Azzziel/Lulus-Online/README.md

# Lulus-Online

is a repository for me and Ivan's final project.
For any of you who stalk around and find your way here, just close, you won't find anything useful :)
