Azzziel/Lulus-Online/Site Hardware/_Asset/Note/Battery Life Calculation.xlsx

Sensor Life Calculation
Expectancy : |  | 1067.408923 |  | Days
Parameter
Timetable |  |  | Current Consumption
1 Day | 24 | hour | Battery Size | 10800 | mAh
Data Sending (20 car) | 100 | times | Arduino Pro Mini |  | mA
Sensor Read (Interval) | 3 | seconds | Sleep | 0.004
Work | 0.2 |  | Work | 3.58
Sleep | 2.8 |  | QMC58831
Park Re-check (Delay) | 5 |  | Idle | 0.002
Work | 0.2 |  | Work | 0.1
Sleep | 4.8 |  | HC12
Data Sending (Duration) | 7 |  | Sleep | 0.022
Sending | 2 |  | Work | 16
Acknowledge | 5 |  | Indicator Resistor (4v on 680k) | 0.005
Standby Time | 0 | hour
Activities
Sensor Read |  |  | Data Sending
Time Calculation |  |  | Time Calculation
1 hour / interval |  |  | 24 hour / count
n : | 1200 |  | n : | 4.1667
t [work]: | 0.0667 |  | t [HC_send]: | 0.0023
t [sleep]: | 0.9333 |  | t [HC_ack]: | 0.0058
 |  |  | t [Re-check_work]: | 0.0002
 |  |  | t [Re-check_sleep]: | 0.0056
Capacity Usage |  |  | Capacity Usage
mAh = I x t | [current, time] |  | mAh = I x t | [current, time]
Work | 0.2471333333 | mAh | HC Send | 0.04534 | mAh
Sleep | 0.0308 |  | HC Acknowledge | 0.11335
Total [1 hour] | 0.2779333333 | mAh | Sensor Work | 0.00086
 |  |  | Sensor Sleep | 0.00018
 |  |  | Total [1 hour] | 0.15973 | mAh
All Sleep
Capacity Usage
mAh = I x t | [current, time]
All [1 hour] | 0.033 | mAh
Battery Calculation
1 Day Calculation
24 Hours = Sensor Read + Send Data + All Sleep
In 1'Working' hour |  |  | 1 Day [Work + Sleep]
Time |  |  | Time
Send Data | 0.0579 | hour | Sleep | 0 | hour
Sensor Reading | 0.9421 |  | Working | 24
Capacity |  |  | Capacity
Send Data | 0.1597 | mAh | Working | 10.1180 | mAh
Sensor Reading | 0.2618 |  | Sleep | 0.0000
Total | 0.4216 |  | Total | 10.1180
Battery Calculation
Capacity | 10800 | mAh
Day | 1067.408923 | day
Year | 1 Year 169 Day
