Azzziel/Lulus-Online/Site Hardware/Sensor Node/Others/Previous Version/01. Fluct State Version/note.txt

Necessary Mentions:
- Fluctuation State
- averaging the Magneto read
