Azzziel/Lulus-Online/3D Design/Sensor Node/PCB Outline.dxf

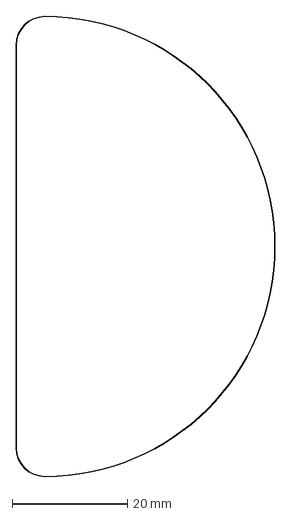
[picture p1: CAD file, 2020-03-23, last stored version]
3D Design/Sensor Node/PCB Outline.dxf
45.0 x 80.0 mm
