Azzziel/Lulus-Online/3D Design/Sensor Node/Case Part.stl

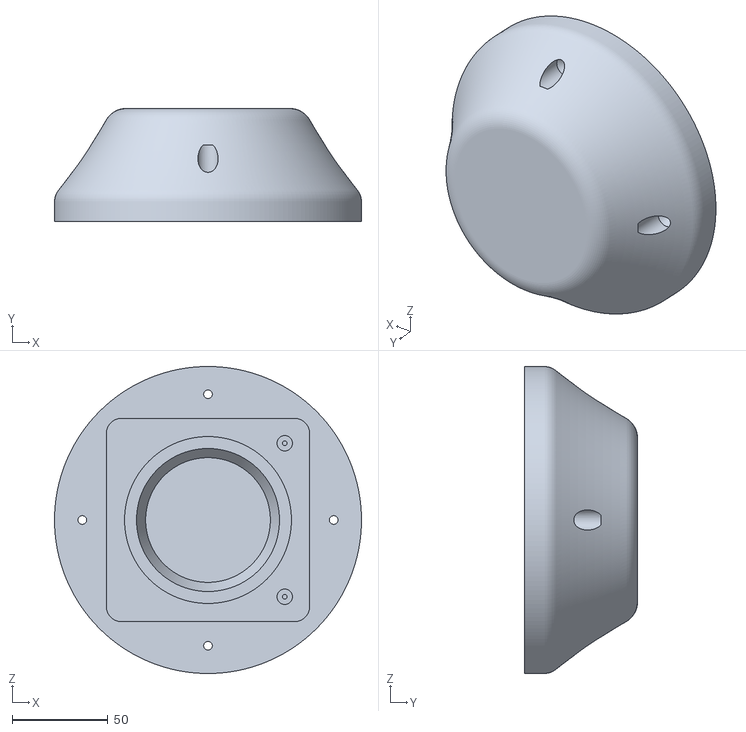
[picture p2: CAD file, 2020-03-16, last stored version]
3D Design/Sensor Node/Case Part.stl
160.0 x 59.0 x 160.0
