Azzziel/Lulus-Online/3D Design/Sensor Node/Module Part.stl

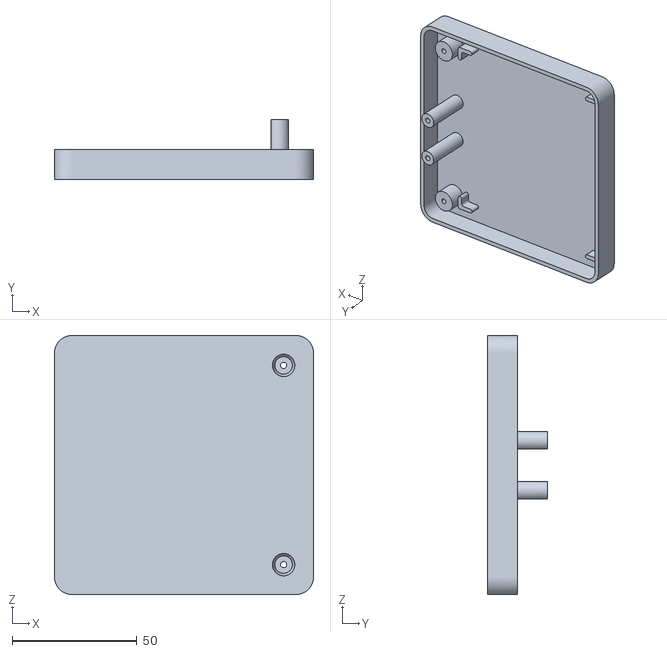
[picture p3: CAD file, 2020-03-16, last stored version]
3D Design/Sensor Node/Module Part.stl
104.0 x 24.0 x 104.0
