Azzziel/Lulus-Online/Site Hardware/_Asset/Code/Sensor Test/1 Week Stability Plotting/Plotter/WriteSD.ino

void WriteSD() {
  myFile = SD.open ("Sensor.txt", FILE_WRITE);

  if (myFile) {
    myFile.print (timeNow);
    myFile.print ("/");
    myFile.println (Message);
    myFile.close ();
  }

  Serial.print (timeNow);
  Serial.print ("/");
  Serial.println (Message);

}
