Azzziel/Lulus-Online/Site Hardware/_Asset/Code/Sensor Test/1 Week Stability Plotting/Wireless_Plotting/Serial_Print.ino

void SerPrint () {
  Serial.print("G : ");
  Serial.print(G);
  Serial.println();
  Serial.print("Temp : ");
  Serial.print(tmp);
  Serial.print("      | Hum : ");
  Serial.print(hmd);
  Serial.println();
}
