Azzziel/Lulus-Online/(commit log)

2020-03-23 Finalizing Sensor Node Code & Tiding up the folder
    [Battery Indicator Calculation.xlsx, Battery Life Calculation.xlsx, Case Part.stl, Module Part.stl, PCB Outline.dxf]
2020-03-23 VSCode integration for the branch
    [PCB Outline.dxf]
2020-03-28 Added prototype of better HC12 code
    Enables automatic baudrate and channel detection
2020-04-01 Reworked SensorNode in-project library
2020-04-02 Removing the 3D Design Folder, use Github solely focused as a code repo. Other documents can be stored in Google Drive and managed in Trello
    [Battery Indicator Calculation.xlsx, Battery Life Calculation.xlsx, Case Part.stl, Module Part.stl, PCB Outline.dxf]
2020-04-14 Too much to say
    [main.cpp]
2020-05-07 Auto message resend and main display aware
    Auto message resend: The microcontroller is now aware of sent messages that has not been replied an ACK. Main display aware: The whole system is now differentiate displays into two categories, main displays and nonmain displays. Main displays display all the sensor nodes in the system regardless of the assigned `disp_rt`.
2020-05-09 Added Ivanized version of Wireless Plotting. "Lambda"-ed Gateway a bit.
2020-05-12 Too much to say (2)
    [Listener_Ivanized.ino, Wireless_Plotting_Ivanized.ino, main.cpp]
2020-05-19 Initial database redesign files
    [config.txt]
2020-05-21 Gateway adapted to the new database design and fixed a bug in the PHP
    [main.cpp]
2020-05-21 SQL Refactoring
    [config.txt]
2020-05-22 Redesigned insert_node_status.php and node_summari
    [main.cpp]
2020-06-07 Patched insert_node_status and is now null-aware
2020-06-07 Patched insert_node_status again, less rows
